Ganghyeok-Lim/Proj-EEG_Measurement_Bd/Rev_A/01_HW/0. JLCPCB Fab File/BOM/EEG Measurement Bd_BOM_240415.xlsx

Comment | Designator | Footprint | Quantity | LCSC Part #
10uF/25V/1608 | C300, C308 | CAP 1608 (0603_INCH) | 2 | C96446
100nF/50V/1608 | C301, C309, C310, C318, C319, C403, C404, C405, C406, C419, C420, C421, C430, C431, C432, C433, C434, C435, C436 | CAP 1608 (0603_INCH) | 19 | C14663
10uF/50V/2012 | C302, C307, C311, C316 | CAP 2012 (0805_INCH) | 4 | C440198
2.2uF/50V/2012 | C303, C306, C312, C315 | CAP 2012 (0805_INCH) | 4 | C377773
100nF/50V/2012 | C304, C305, C313, C314, C411, C429 | CAP 2012 (0805_INCH) | 6 | C49678
10uF/10V/1608 | C317, C320 | CAP 1608 (0603_INCH) | 2 | C19702
470nF/50V/2012 | C400, C401, C410 | CAP 2012 (0805_INCH) | 3 | C13967
1nF/50V/1608 | C402, C409, C414, C415, C418, C424 | CAP 1608 (0603_INCH) | 6 | C1588
1uF/50V/1608 | C407, C408, C412, C413, C416, C417, C422, C423, C425, C426, C427, C428 | CAP 1608 (0603_INCH) | 12 | C15849
SMW250-02 | CN300 | CON_SMW250-02 | 1
DC_Jack | CN400, CN401, CN402 | CON DC-Jack | 3
PH_3P | CN403 | CON PIN_HEADER-3PIN(2.54MM) | 1
10144518-041802LF | CN500, CN501 | CON_BergStak-Lite(0.8mm)_PLUG-40P(10144518-041802LF) | 2 | C5410298
100uF/35V/6.3Øx7.7 | EC300, EC301 | CAP ALSMD 6.6MM H7.7MM | 2 | C176666
GREEN/2012 | LED300 | LED MHT170RGBCT (GREEN) | 1 | C2962094
10K/2012 | R300, R304, R432 | RES 2012 (0805_inch) | 3 | C17414
2K/2012 | R301 | RES 2012 (0805_inch) | 1 | C17604
150R/2012 | R302, R303 | RES 2012 (0805_inch) | 2 | C17471
100R/2012 | R305, R407, R408, R425, R443 | RES 2012 (0805_inch) | 5 | C17408
0R/2012 | R306, R307, R309, R311, R313, R400, R401, R402, R403, R404, R405, R411, R415, R422, R423, R424 | RES 2012 (0805_inch) | 16 | C17477
4.7K/2012 | R308 | RES 2012 (0805_inch) | 1 | C17673
220R/2012 | R310, R417, R426 | RES 2012 (0805_inch) | 3 | C17557
820R/2012 | R312 | RES 2012 (0805_inch) | 1 | C17837
1M/2012 | R406 | RES 2012 (0805_inch) | 1 | C17514
2M/2012 | R409, R410, R427 | RES 2012 (0805_inch) | 3 | C26112
1K/2012 | R412 | RES 2012 (0805_inch) | 1 | C17513
3.9M/1608 | R413, R429 | RES 1608 (0603_inch) | 2 | C227875
39.2K/1608 | R414, R430 | RES 1608 (0603_inch) | 2 | C137734
2.2K/2012 | R416, R428 | RES 2012 (0805_inch) | 2 | C17520
3.9K/2012 | R418, R419, R420, R421, R433, R434, R435, R436, R437, R438, R439, R440 | RES 2012 (0805_inch) | 12 | C17614
200K/1608 | R431 | RES 1608 (0603_inch) | 1 | C25811
20R/2012 | R441 | RES 3216 (1206_inch) | 1 | C17544
330R/2012 | R442, R444 | RES 2012 (0805_inch) | 2 | C17630
SB | SB300, SB301, SB400, SB401, SB500 | SB (Solder-Bridge) | 5
TP_HOLE(1MM) | TP400, TP401, TP402, TP403, TP404, TP405, TP406, TP407, TP408, TP409, TP410, TP411, TP412, TP413, TP414, TP415, TP416 | TP_HOLE(1MM) | 17
TP_CIRCLE | TP500, TP501, TP502, TP503 | TP Circle | 4
LM317AG-TN3-R | U300, U302 | IC_TO-252-2(DPAK) | 2 | C75510
TLV171IDBVR | U301, U400, U401, U402, U404, U405, U406, U408, U409, U410, U411, U412 | SOT-23-5 (TI DBV PACKAGE) | 12 | C2864299
AMS1117-3.3 | U303 | SOT 223-3 (DIODES INCORPORATED) | 1 | C6186
INA826AIDR | U403, U407 | IC_SOIC-8 (4.90x3.90mm) | 2 | C38433
BU79100G-LATR | U413 | IC_SOT-23-6 | 1 | None
