Ganghyeok-Lim/Proj-EEG_Measurement_Bd/Rev_A/01_HW/EEG Measurement B'd/EEG Measurement B'd.pdf

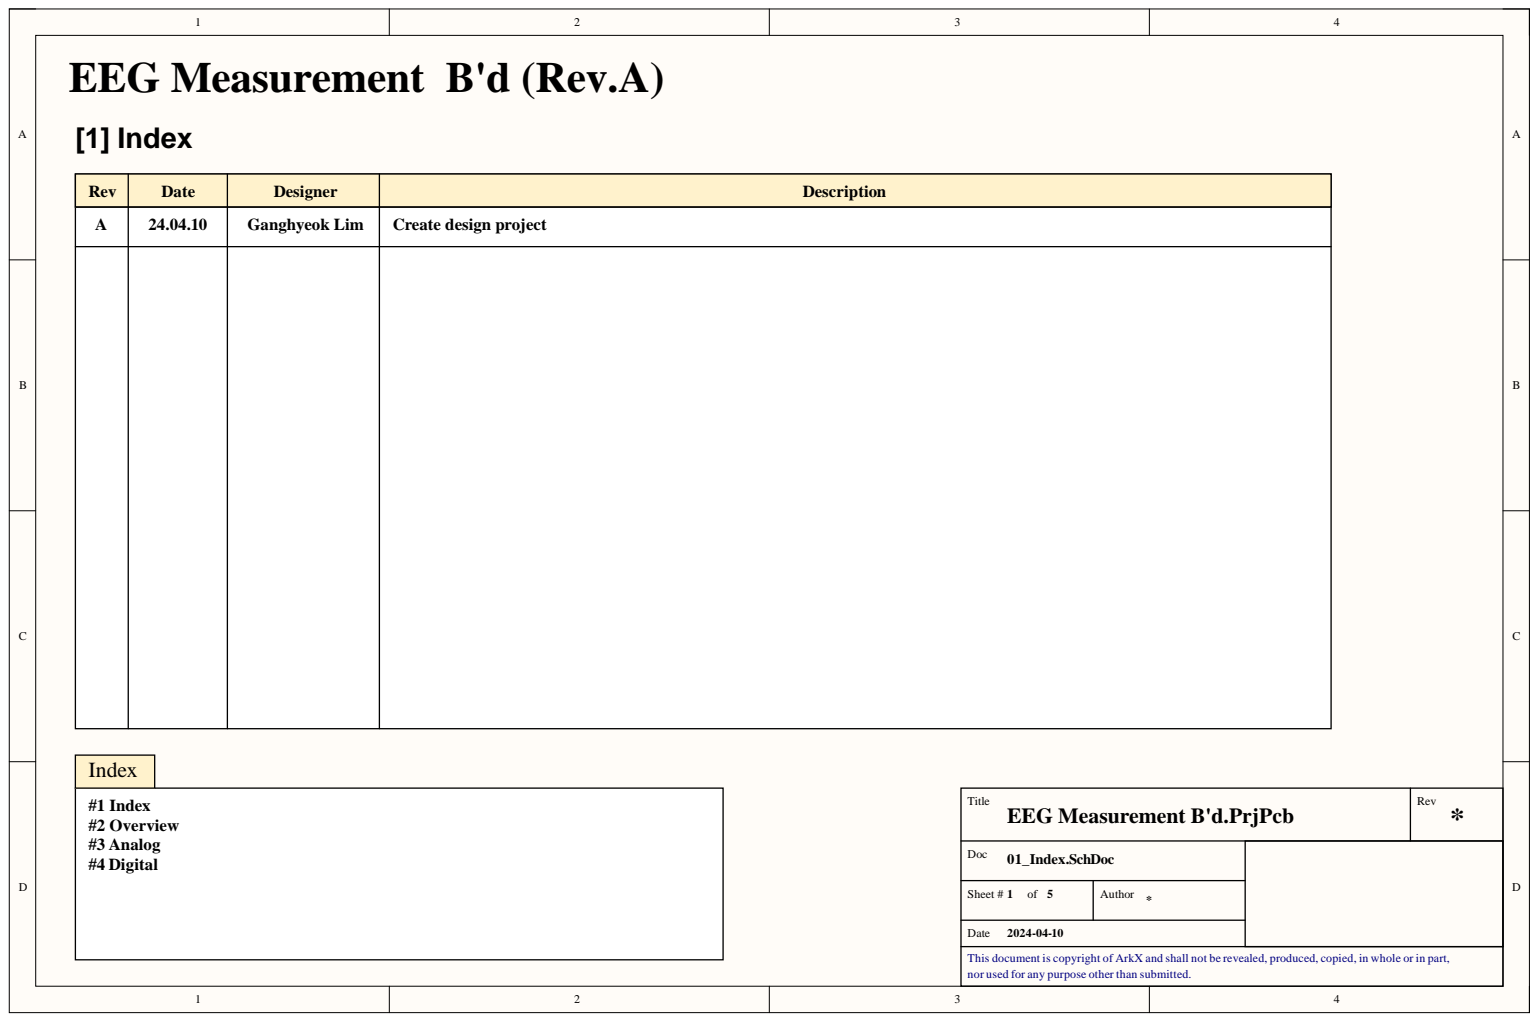
[picture p1: page 1]

Rev | Date | Designer | Description

A | 24.04.10 | Ganghyeok Lim | Create design project

Doc 01_Index.SchDoc

Sheet # 1 of 5 | Author *

This document is copyright of ArkX and shall not be revealed, produced, copied, in whole or in part,
nor used for any purpose other than submitted.

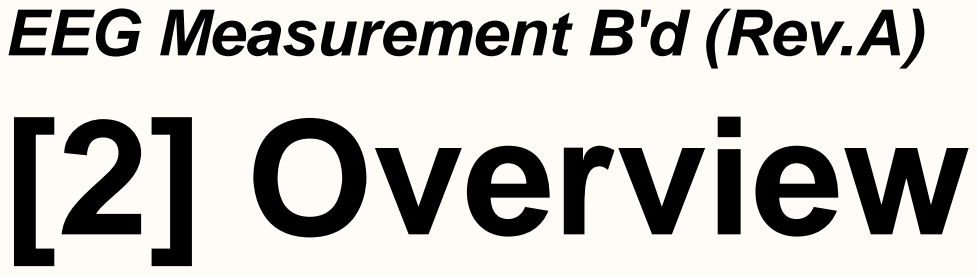
[picture p2: page 2]

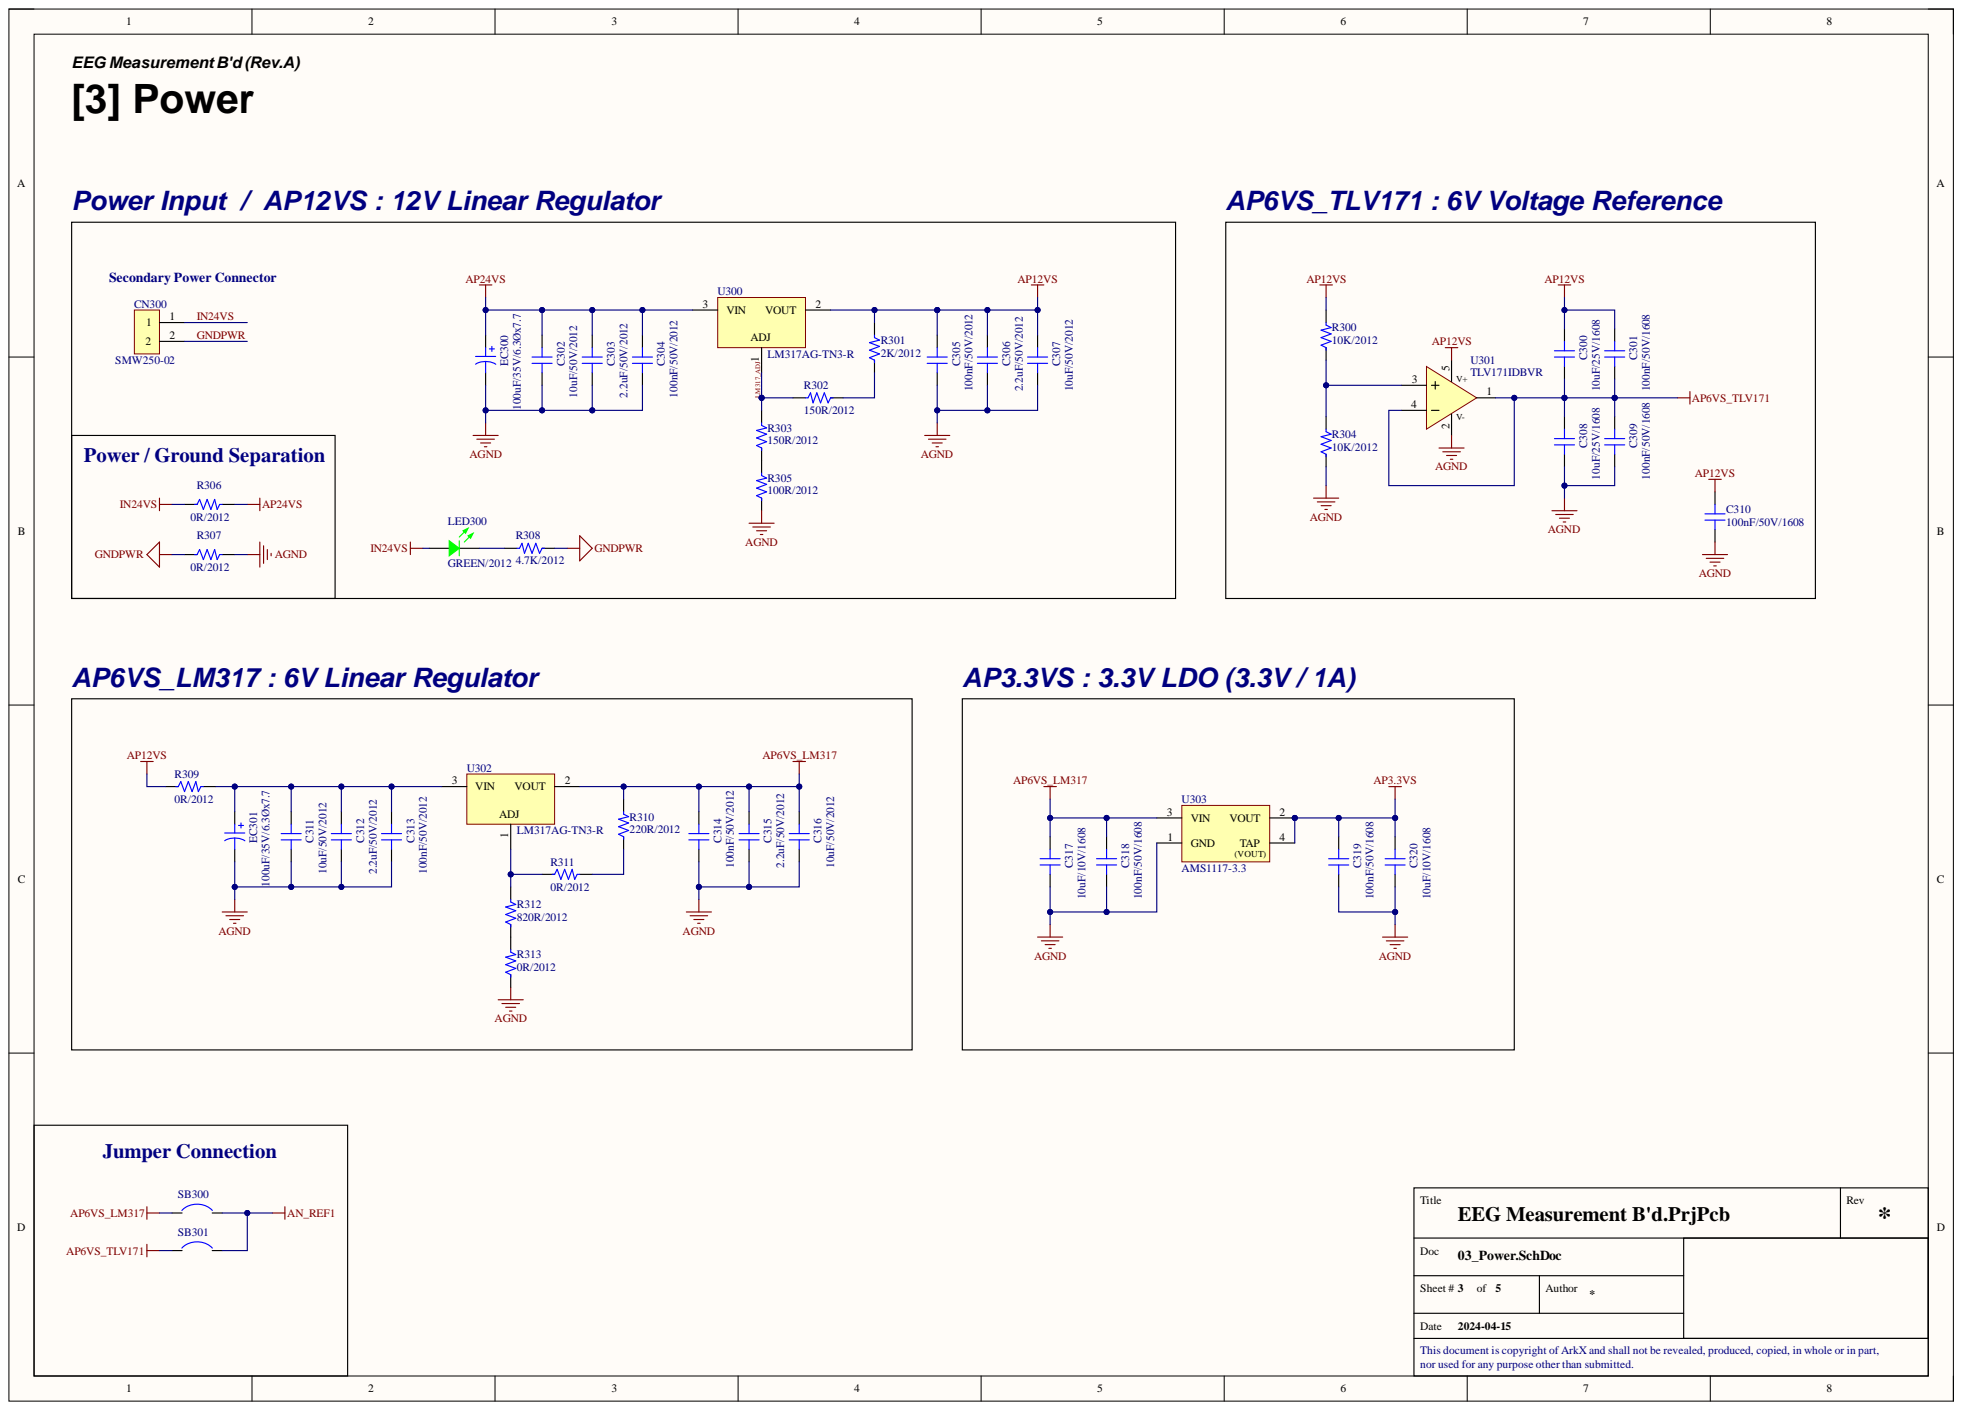
[picture p3: page 3]

Power Input / AP12VS : 12V Linear Regulator

Title EEG Measurement B'd.PrjPcb | Rev *

Doc 03_Power.SchDoc

Sheet # 3 of 5 | Author *

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

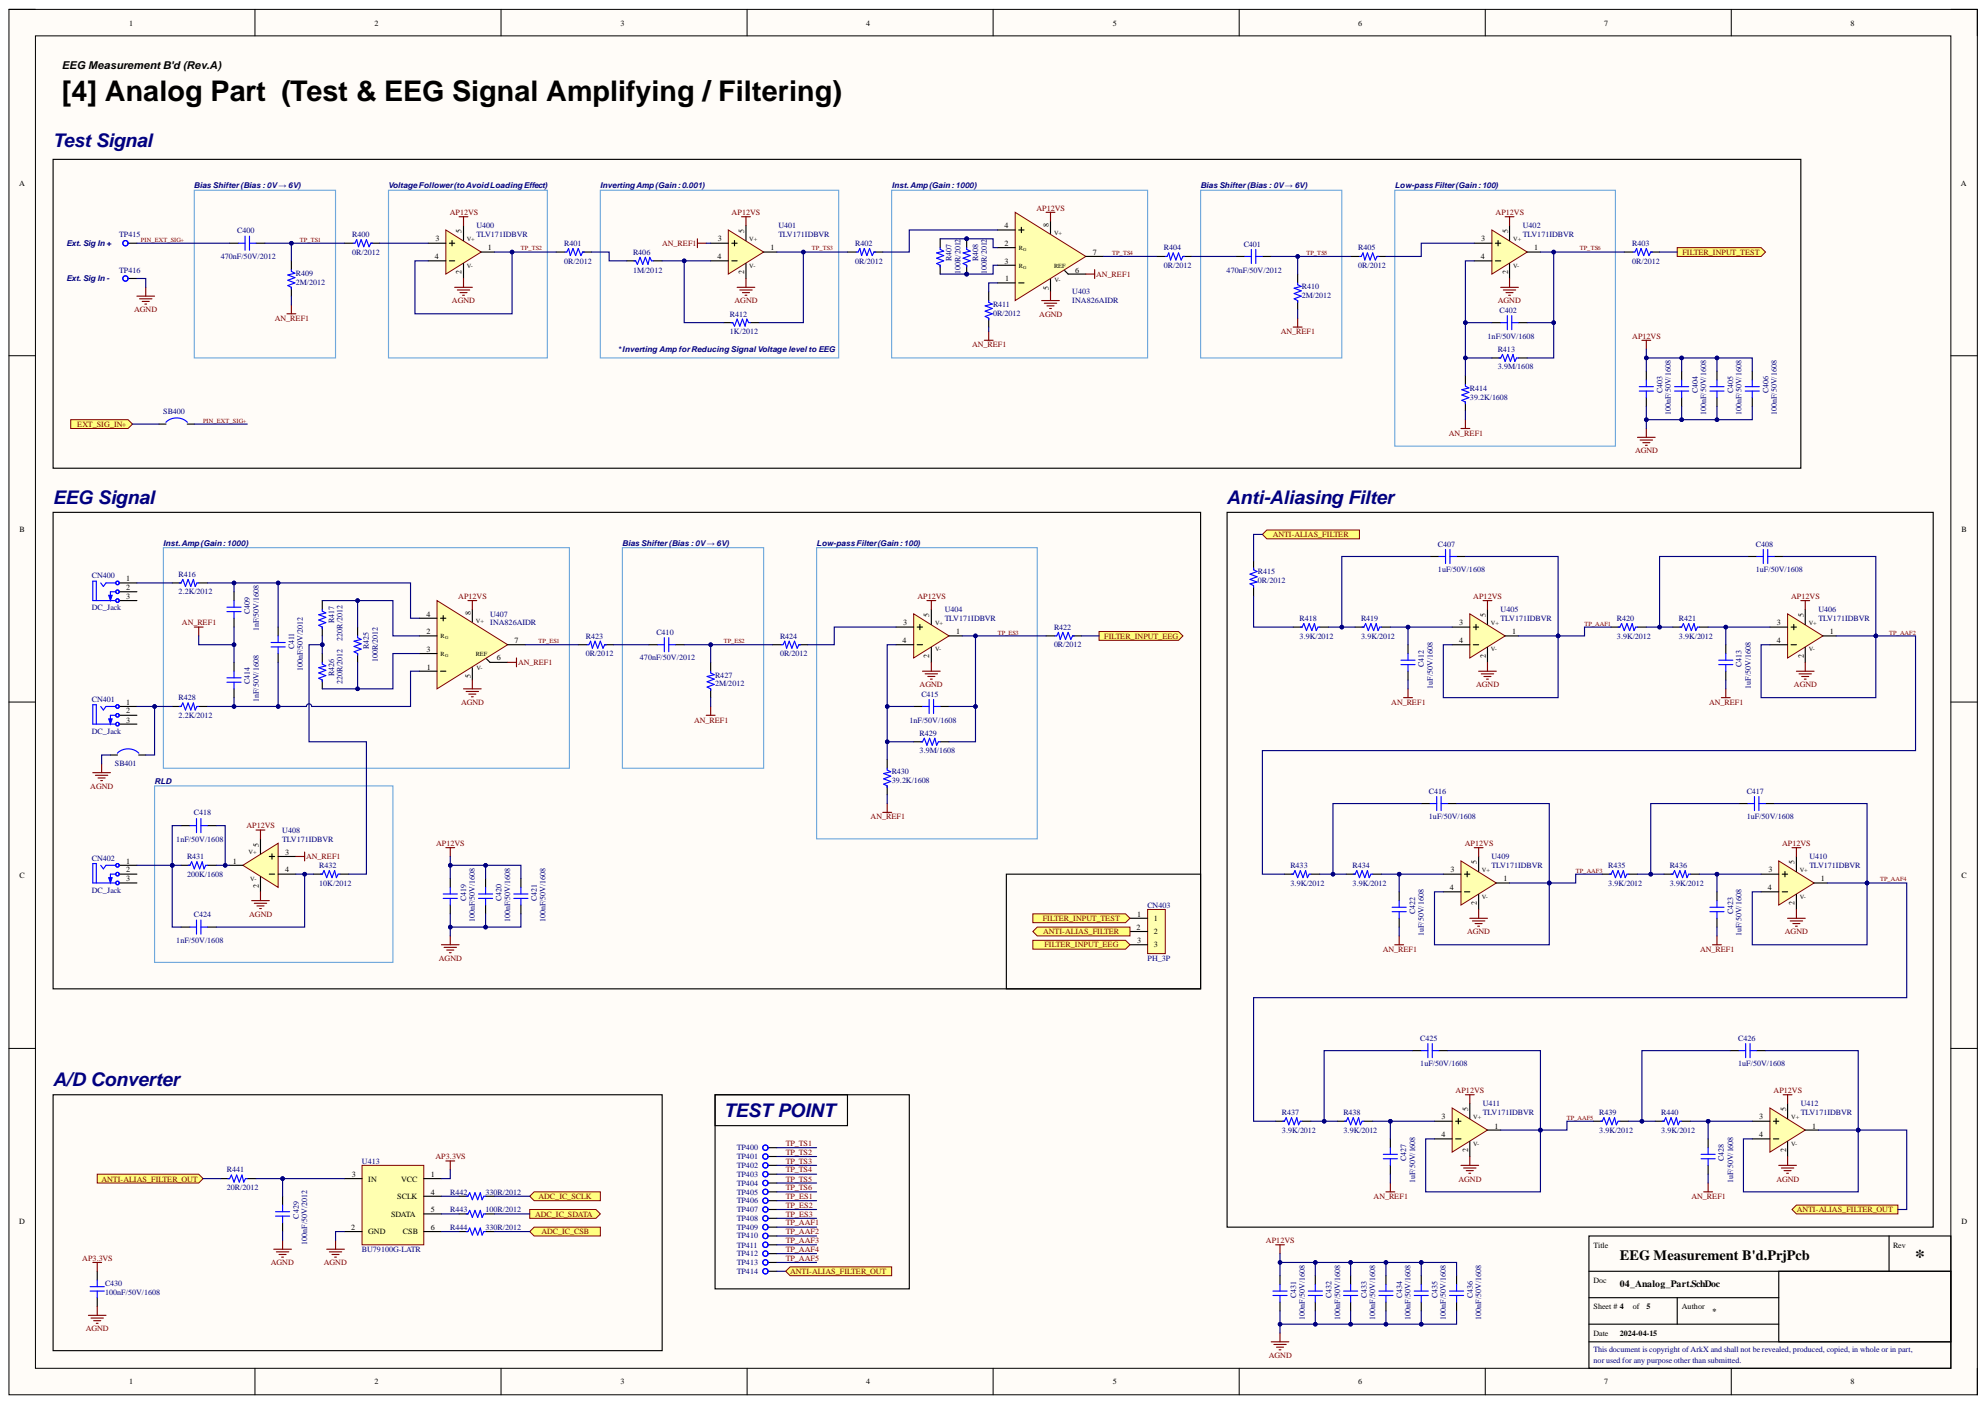
[picture p4: page 4]

EEG Measurement B'd (Rev.A)
[4] Analog Part (Test & EEG Signal Amplifying / Filtering)

Low-pass Filter(Gain : 100)

*Inverting Amp for Reducing Signal Voltage level to EEG

Title EEG Measurement B'd.PrjPcb | Rev *

Doc 04_Analog_Part.SchDoc

Sheet # 4 of 5 | Author *

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

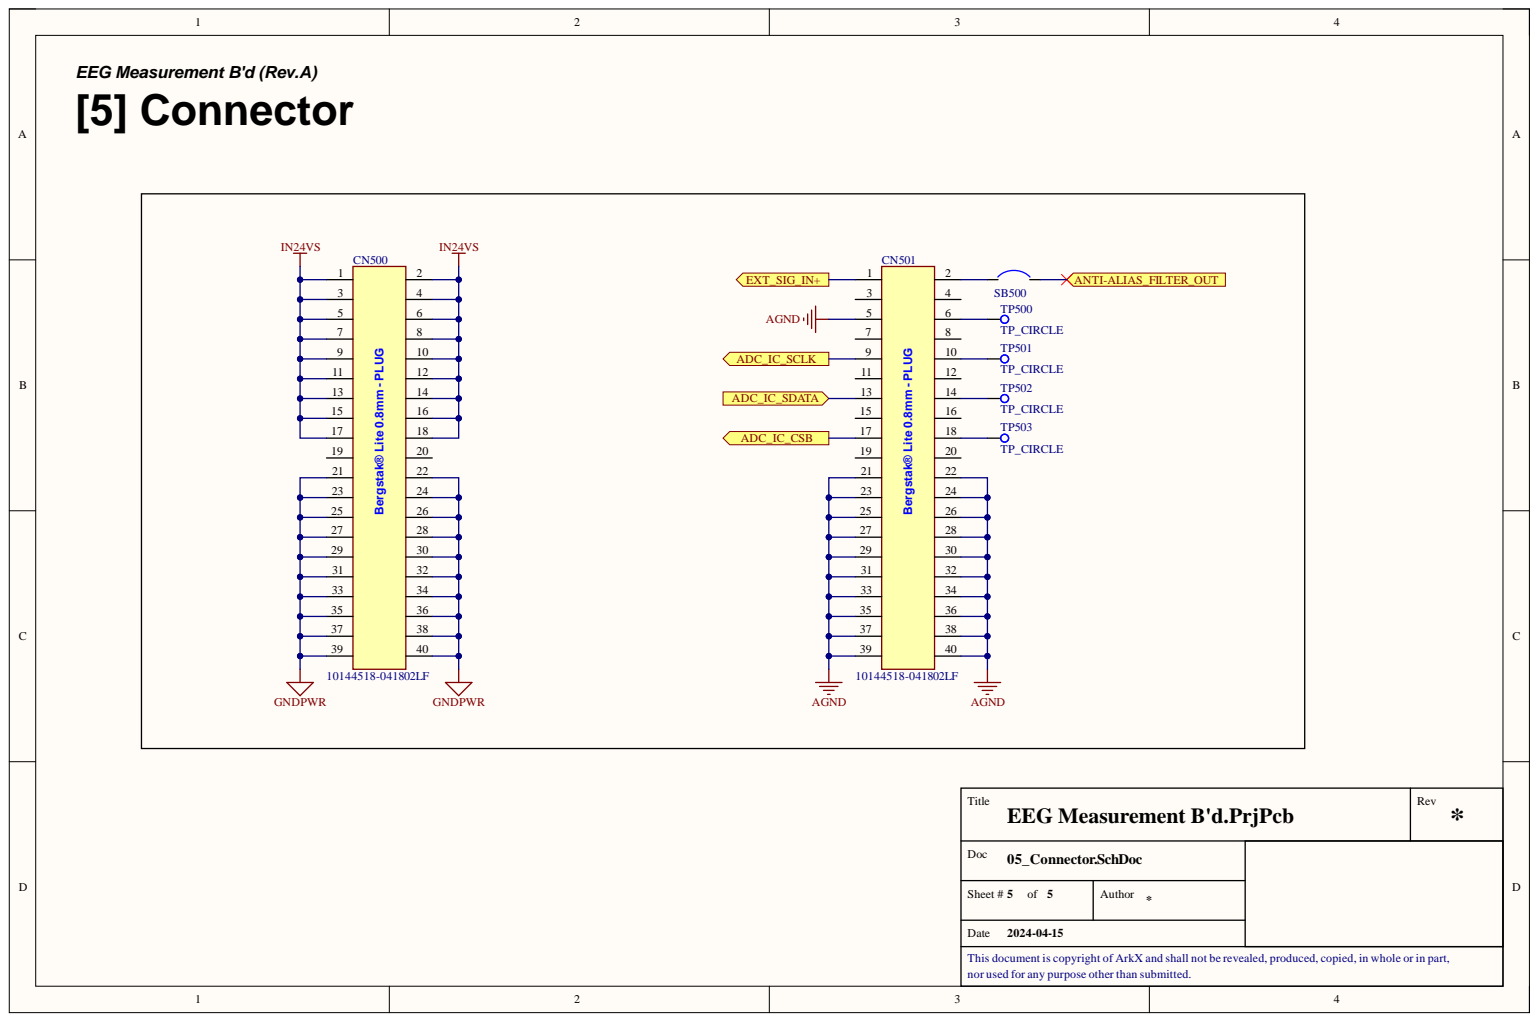
[picture p5: page 5]

Title EEG Measurement B'd.PrjPcb | Rev *

Doc 05_Connector.SchDoc

Sheet # 5 of 5 | Author *

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

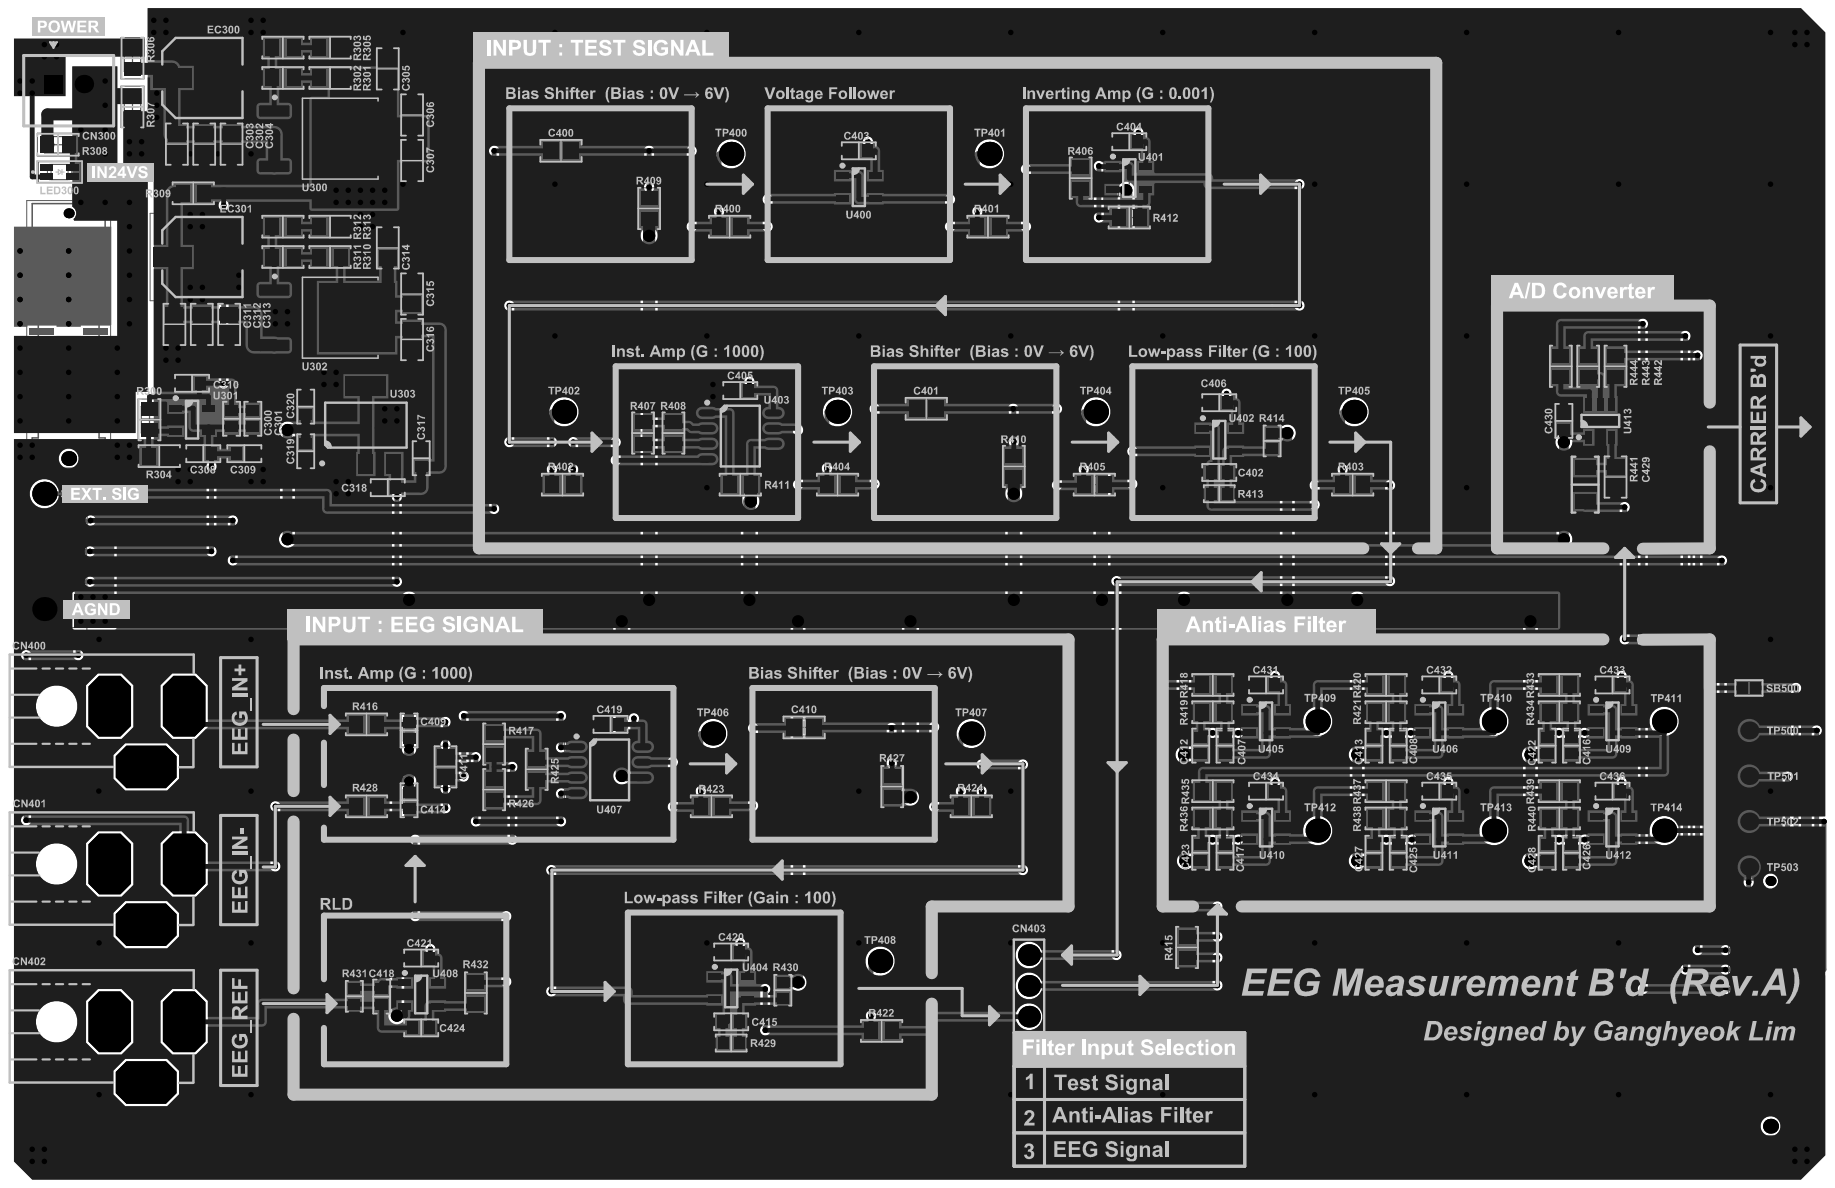
[picture p6: page 6]
