Ganghyeok-Lim/Proj-EEG_Measurement_Bd/(list of files, drawings)

Other design files:
Rev_A/01_HW/EEG Measurement B'd/01_Index.SchDoc
Rev_A/01_HW/EEG Measurement B'd/02_Overview.SchDoc
Rev_A/01_HW/EEG Measurement B'd/03_Power.SchDoc
Rev_A/01_HW/EEG Measurement B'd/04_Analog_Part.SchDoc
Rev_A/01_HW/EEG Measurement B'd/05_Connector.SchDoc
Rev_A/01_HW/EEG Measurement B'd/EEG Measurement B'd.PrjPcb
