Ganghyeok-Lim/Proj-EEG_Measurement_Bd/(commit log)

2024-04-12 [HW] Feat : Add Altium Schematics & Design in progress
    [01_Index.SchDoc, 02_Overview.SchDoc, 03_Power_Analog_Part.SchDoc, 04_Analog_Part.SchDoc, 05_Power_Digital_Part.SchDoc, 06_Digital.SchDoc, 07_Connector.SchDoc, EEG Measurement B'd.PrjPcb]
2024-04-17 Complete Sch & PCB Artwork
    Complete Sch & PCB Artwork & Generate Fabrication Data
    [03_Power.SchDoc, 03_Power_Analog_Part.SchDoc, 04_Analog_Part.SchDoc, 05_Connector.SchDoc, 05_Power_Digital_Part.SchDoc, 06_Digital.SchDoc, 07_Connector.SchDoc, EEG Measurement B'd.PrjPcb]
